mokweri/STM32F4-Board/README.md

# STM32F4-Board
Development board based on STM32F407

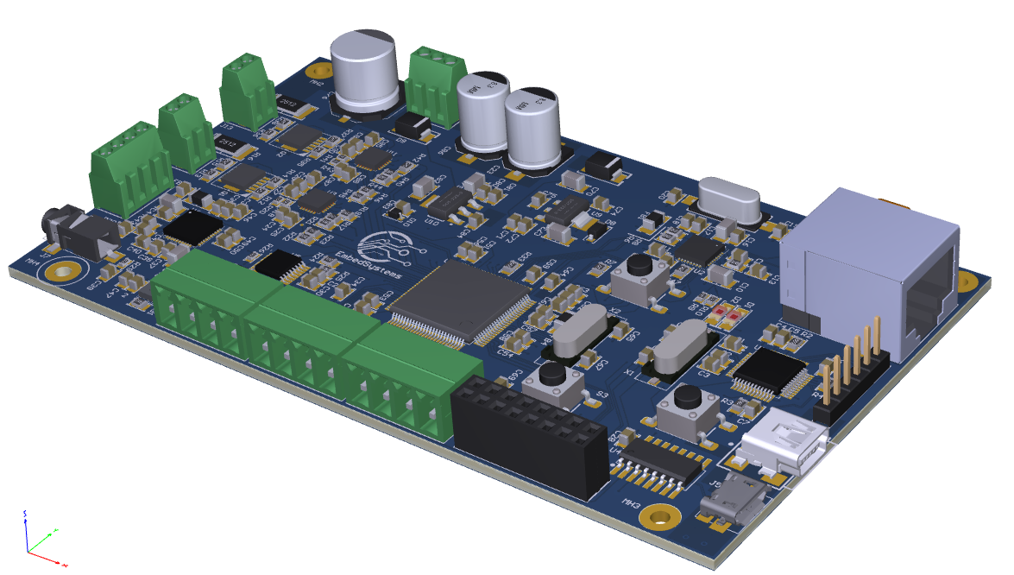
[picture p1: Release Files/images/6.PNG]
