mokweri/STM32F4-Board/Design Documents/Project+Discussion.xlsx

Sheet: DAY-1
Main Controller | x gpio | Manufacturers | Jtag/swd
 | y i2c | Availability
 | z uart, | Costing
 | clock freq | Prog
 | Flash Memory | Resou
 | RAM
 | Voltage
Debugger | Controller should be from same family
 | no of bit should be same
no of address Locations | 2^no of bit
 | Clock Freq
 | Programing Interface
Ethernet PHY | Datalink Layer
 | Physical Layer
MII/RMII | Media( Twisted, Fibre optics etc)
mii (16 Signal) | 100Mb/s
rmii (7 signal) | 1000Mb/s
gmii | 10,000Mb/s
MII Clock | 25Mhz
Phy | Driver Avail.
UART TO USB Conveter | FTDI232, CH340C
Parameter for ADC | No of Bit | 24
 | Reference Reg | 5V
 | Prog Gain Amp | 128
 | Sampling Rate | 100SPS
 | Data+ Data- | 0 to 10mv
4 Wire load cell | CM (Voltage b/w Data pin and GND) | 5V
Sesnor (5KG Load Cell)
Seensitivity | 1mgrm/v | 5mgrm
Extitation Voltage | 5v
No of steps | 1000000
Min no of Bits required | 20
SAMPLING Rate | 1000 sps
Sampling Filer
no of channel | 1 diff channel
Conectivity | UART, I2C, SPI
Feature ADC | ESD, Noise rejection
Noise free bits
Effective Biits
Voltage Level
Motor Driver | Bi Directional
 | 0 -100% | PWM
 | Voltage Level Motors | 12v
 | Logic level Voltage | 3.3v
 | Motor Type | Brushed DC
 | Technology | Power Mosfet
 | Interface | 1 gpio, 1pwm
 | Protection | Overcurrent,
 | Sense Current | 1 ADC
 | Price
Mosfets | RDS(ON) | Should Min
 | I Drain | >3.5A
 | V (GS) | >9V
 | IDS(Off) | Min
 | Power Dis | iload^2 x RDS(ON)
 | RT(JA) | Min
 | Total Gate Charge | delay(charge the gate) | min
 | Switching Loas (inc) with total gate change
 | No of elements | 4
Dac | Sampling Rate | 64x Fs
 | No of channel required | 1
 | Interface | I2S
 | Resolution | 32bit
 | no analog O/P | 1 For headphone, 1 speaker
 | Volatge Level | 3.3v
 | integrated Microphone | 1
 | monotocity
 | Range of Audio(db) | High minus -low Audio
Main Controller | STM32F407VGT6
Programmer/debugger | STM32F103CBT6
Ethernet PHY | DP838261RHBR
UART TO USB2.0 | CH340C
ADC (Load cell) | ADS122C04IPW
motor driver | DRV8701E
mosfet | DMHT6016LFJ
DAC with Mic

Sheet: DAY-2
STM32F103 | Page-11 | Block Diag
 | Page- 15 | Booting Config
 | Page-26 | PIN Names, Package info
 | 28-33 | Pin Config Table
 | Page-35 | Load Cap, VDD
 | Page-36 | Voltage Page
 | Page-37 | Max Power Est
 | Page-51 | Clock Config
 | Page-60 | ESD Table
 | Page-68 | Reset
 | Page-70 | I2C Pull-ups
 | Page-78 | Design Guidelines
Bypass Caps
Series Termination Resistance | 1Mhz | 3.3v<x
 | ns
10R | 0.2V

Sheet: Day-3
ESD DIODES/TVS DIODES | Leckage Current
ESD3V3D9 | Standoff voltage | 3.3V
 | Break down voltage | >3.3V
 | Clamping Voltage
 | Paracitic cap | Min
XC | 1/2 PI F C | FC(High), C(High) Imp (Low)
 | TX+, TX-, RX+, RX-
Magnetics with RJ45 | RJ45 With Mag
G8X-188S7-BP
 | Working Voltage
 | Isolation Voltage
 | Speed
Ferrite Bead | R dc | Min
MPZ1608B471ATA00 | IMP | Maximum
 | FREQ | Range of freq
 | Current | Current of line
SWD/JTAG
SWD | SWDIO, SWCLK, GND
JTAG(4/5) | JTNRST, JTCK, JTMS, JTDI, JTDO, GND
SWD | JTAG
Programming / debugging | testing (Max processing)
Arm arch | independent
print during deb | not
Symbol Desing | IPC-STD-2612
Footprint | IPC-STD-7351

Sheet: DAY-4
ICHOP | 3A
VREF | ? | 3.05V
VOFF | 0.05V
AVDD | 4.8V
Gain | 20
Vout | r2*vin/(r1+r2)
3r1+3r2=r2*4.8
r1/r2 | 1.8/3.3 | 0.5
r1 | 1.5k
r2 | 3k
Page no | 17
application Page | 28
BULK CAPS
CMIN | D*(1-D)*IO/ DELV*Fsw
D | Vo*100/VIN*eff
I0 | 7.6A
VIN=VOUT | 12V
fsw | 60000
eff | 81
delv | 0.12
D | 1.2
Cmin | 250uF
3A | ~100uF
ESR | min
Ripple Current | Max
ADC
Page No | 52 | Filter Calc
FC | 1/(2*PI*(R1+R2)*CDIF) | r1=r2=1k
1000
CDIF | 100nF
CM1=CM2 | 10nF

Sheet: DAY-5
Charge Pump: | i/p 12v | 24v | Caps | Polar | Non polar
 | 12 |  |  |  | Ceramic
Arangement of Capacitor, Diode, CLK, Gates |  |  |  |  | Class a, Classb
V1 + V1 | 2X 5V | Load voltage |  |  | Class a (Stable, Low Leackage, Low ESR)
Adv | Less compo | Min complex |  |  | MLCC(multilayer ceramic capacitor)
STM32F407
Page-19 | block | SWD/JTAG
Page-24 | Boot pins
Page-25 | PRD ON and Vdd conditions
Page-77 | VDDs, VREF, AVDD, GNDs |  | Pending
Page-82 | Low esr req. for Vcap1 &2 |  | PHY RESET | GPIO
Page-102 | Crystal req |  | Motor driver | 1 PWM, 3 GPIO, 1ADC _IN | X2
Page-112 | ESD Ratings |  | CH340C | 1GPIO
Page-119 | Reset conditions |  | ADC | 2 GPIO
 |  |  | DAC | 1GPIO
 |  |  | MIC | 1 PWM 1 GPIO
Place zener on 1.8
Change net labes motor-2

Sheet: DAY-6
Rules | Some Advantages of MultiLayer Board
First thing is these rules are not enough, because there can be 100s of Rules for a complex PCB. | increases the board's ability to distribute energy
1. ground plane boards are better because they allow signal routing in a microstrip or stripline configuration. It also significantly reduces the ground impedance and, therefore, the ground noise; | reduces cross-interference, eliminates electromagnetic interference
2-high speed signals should be "routed" on intermediate layers located between the various levels. In this way, ground planes can act as a shield and contain the radiation coming from the tracks at high speed | supports high-speed signals
3- a signal layer must always be adjacent to a plane | While a stackup level allows you to get multiple electronic circuits on a single board through the various layers of PCB board
4- Multiple ground planes are very advantageous, since they lower the board's ground impedance and reduce radiation in a common way; | a stack of PCB layers can help minimize the circuit vulnerability to external noise, as well as minimize radiation and decrease impedance and crosstalk problems on high-speed systems
5. the power to Power or GND to GND planes must be rigorously coupled together; | good PCB stacking can also contribute to efficient and low-cost final production;
6- Configurations should be symmetric. For example, on an eight-layer PCB, if level 2 is a plane, level 7 should also be a plane | a correct stack of PCB layers can improve the electromagnetic compatibility of the project.
7. Put the signal levels next to the levels of the plane (ground or power) the return current can flow on an adjacent plane reducing the inductance of the return path to a minimum; | The higher the number of layers, the more the designer is free to unravel his circuit, with less chance of stumbling into "impossible" solution
8. to further improve noise and EMI performance, insulation between a signal layer and its adjacent plane can be made even thinner;
9. an important consideration to be done is the thickness of each signal layer. There are standard thicknesses together with the properties of different types of printed circuit material. When selecting the materials, it is advisable to consider their electrical, mechanical and thermal properties;
Following Factors we have to thing Before and during the design
No of Layer
Number of Planes and Type of Planes
Sequence of Layers
Spacing b/w the Layers

Sheet: Grounding
Grounding
1- Leave nothing unconnected (Fill gnd)
2- Never split the gnd under the signal (Multilayer )
Always connect gnd on common point
Minimize the series via (High freq)
Try to route GND tracks from the biginning (2 layer , 1 layer)
GND to Chasis GND
Reason of Chasis should be gnd(To electric shock)
Current flow from body
higher potential (Body is lower pot)
Lets suppose something touching chasis
0V at chasis
to maintain 0v on chasis we connect it to GND
Very Big PCB, (Try to place Low value cap and Mega ohm reg on every monting hole)

Sheet: day-10
Reverify the schematic | Power Nets | Loads
Critical (Reset, Analogs, sesnors, etc) -Create design rules for Clearance | 12v | 12v (Q2), 12V(U9) | R19
Differential Tracks | 12v Series element NETC84_2 | 3V3 (u8),
Digital tracks | 3V3 | 1v8(u6), 3v3(u6,u7),
Check for each polygon pour | 12v Series element NETC90_2 | 3v3(u5)
 | 1v8 | 3v3(u4)
Place all the designators and naming | 3v3 Series load Net c11_2 | 12v(q1), 12v(u3) | R43
Add a clearance rule for 5mil, adjust all the violations |  | 3v3(u2)
 |  | 3v3(u1)
Current density, Voltage drop (PDN Analysis)
A/unit area

Sheet: Bonus Session
All I/O Voltage Nets | Loads at different Volatge
12V | 12V (Q1,Q2), Current Sesnse (R19, R43)
Series Ele. Netc84_2 | NETC84_2 (U10)
3V3 | 3V3(U1, U2)
