mokweri/STM32F4-Board/Design Documents/7 Layers of OSI Model.PNG

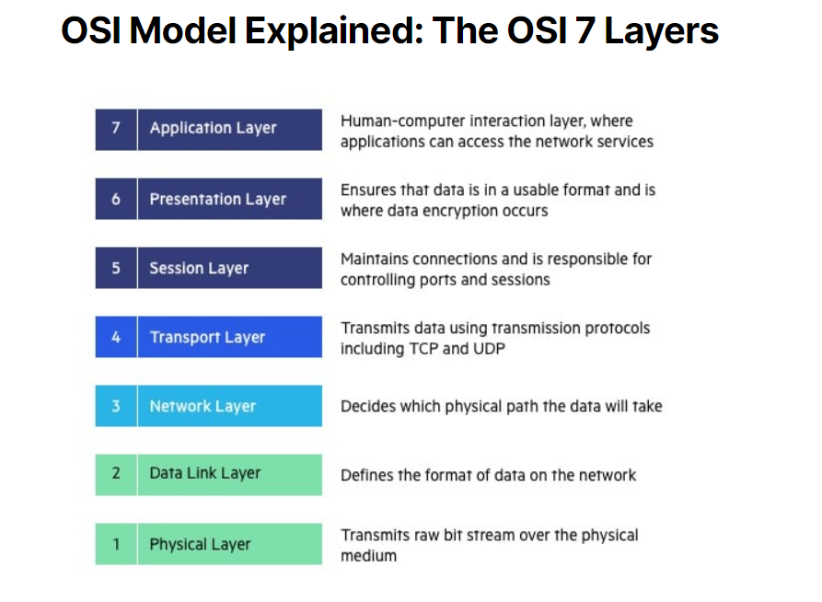
Design Documents/7 Layers of OSI Model.PNG
