mokweri/STM32F4-Board/Design Documents/Full bridge.jpg

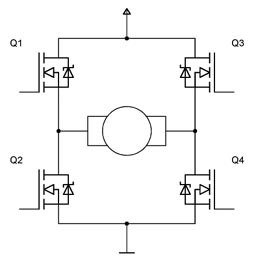
Design Documents/Full bridge.jpg
