mokweri/STM32F4-Board/Design Documents/Power Budget.PNG

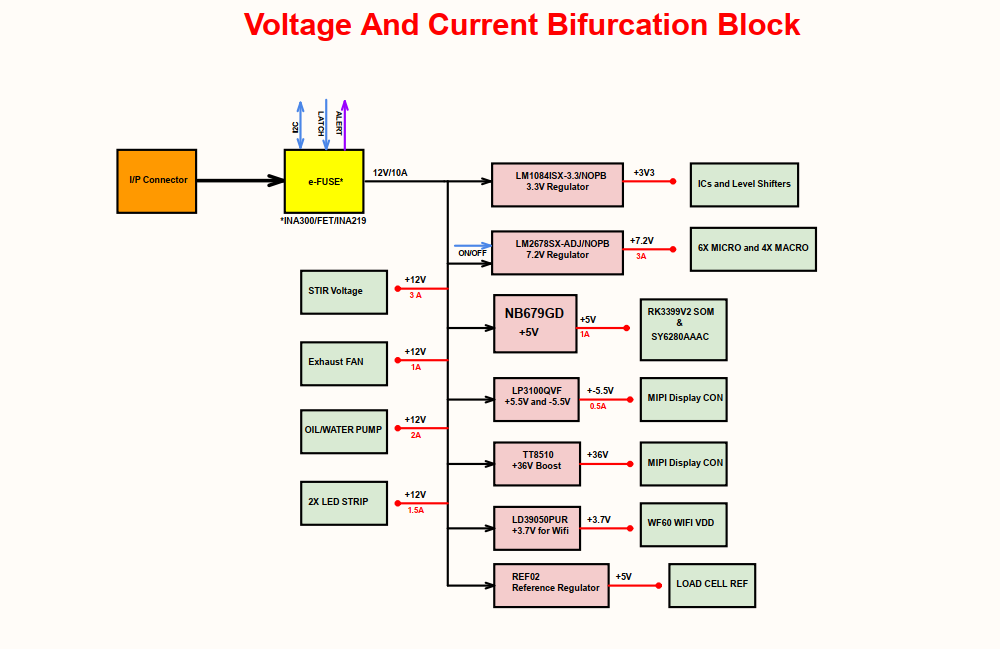
Design Documents/Power Budget.PNG
