mokweri/STM32F4-Board/Design Documents/Schematic Block.PNG

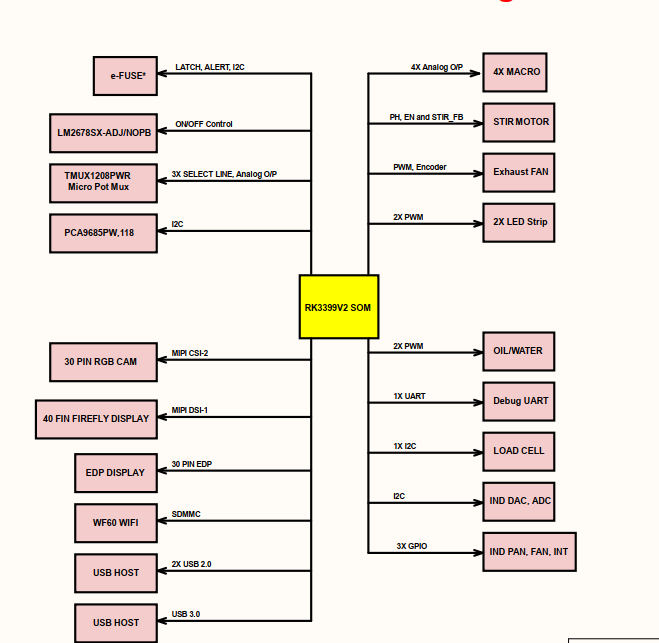
Design Documents/Schematic Block.PNG
