mokweri/STM32F4-Board/Release Files/images/1.PNG

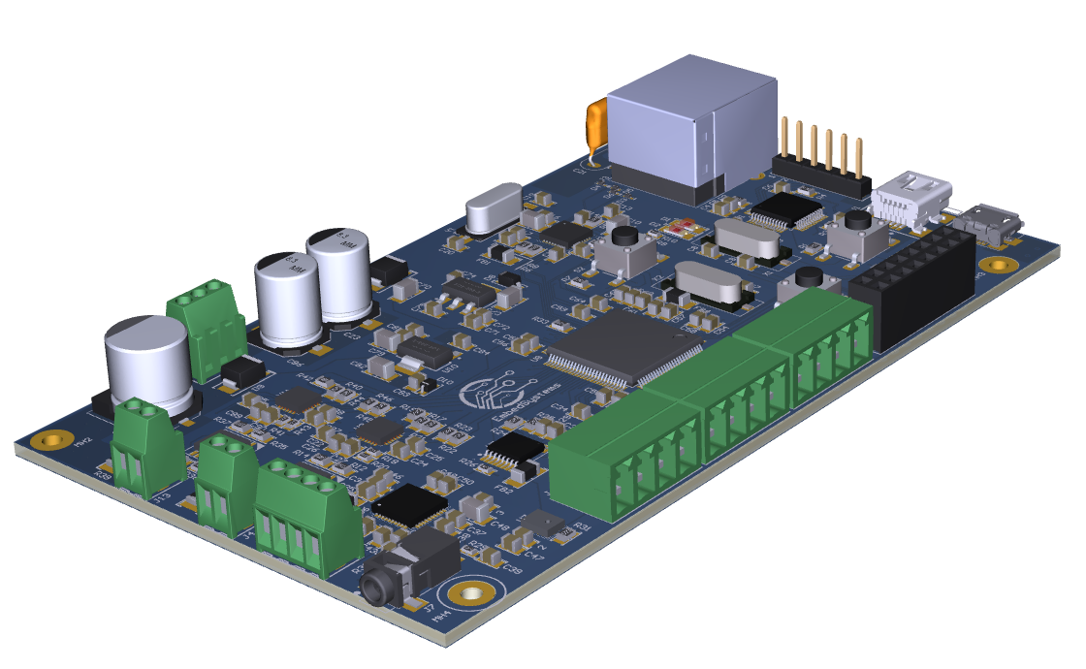
Release Files/images/1.PNG
