mokweri/STM32F4-Board/Release Files/images/2.PNG

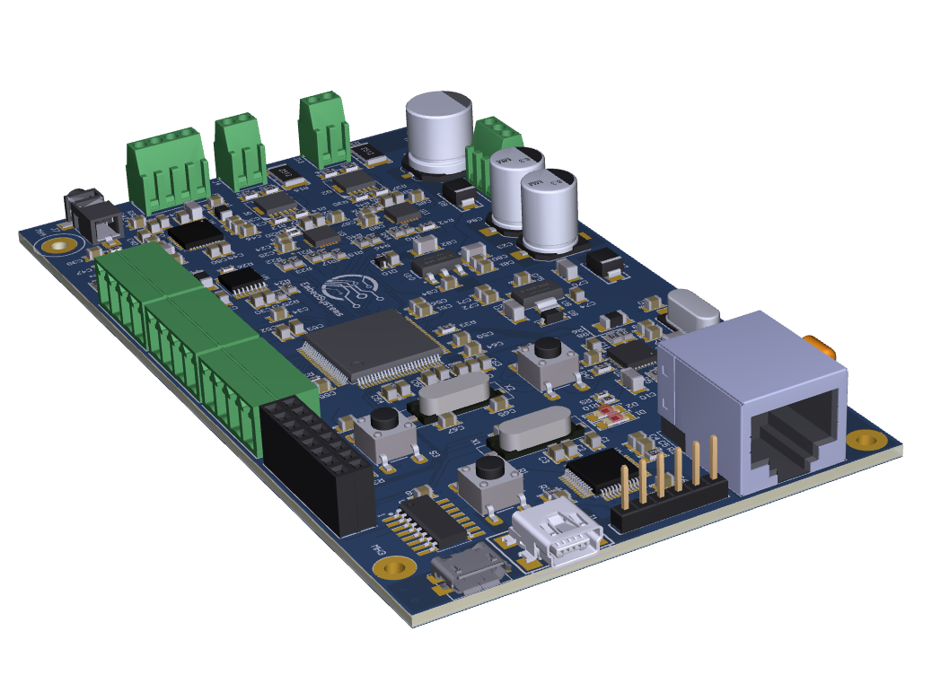
Release Files/images/2.PNG
