mokweri/STM32F4-Board/Release Files/images/3.PNG

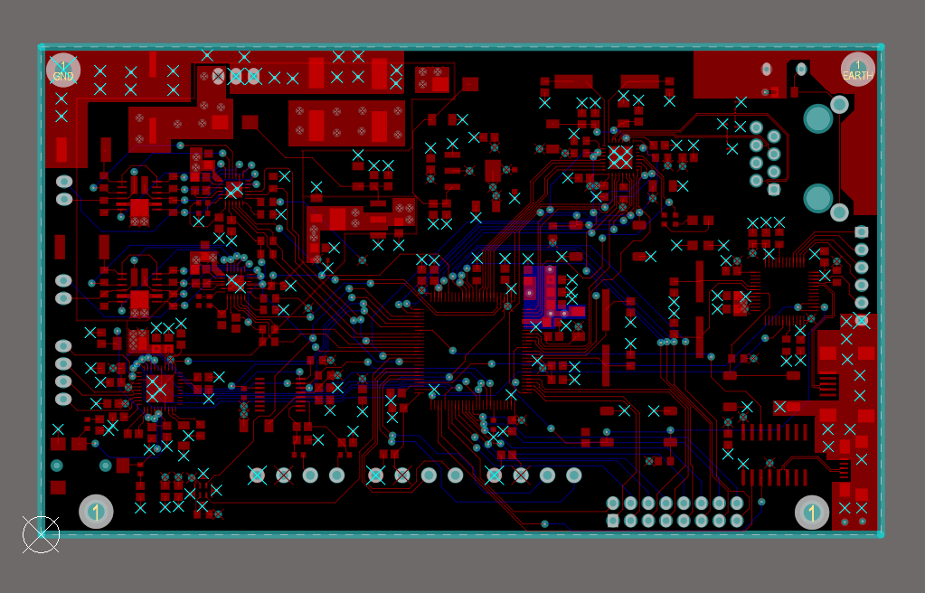
Release Files/images/3.PNG
