mokweri/STM32F4-Board/Release Files/images/4.PNG

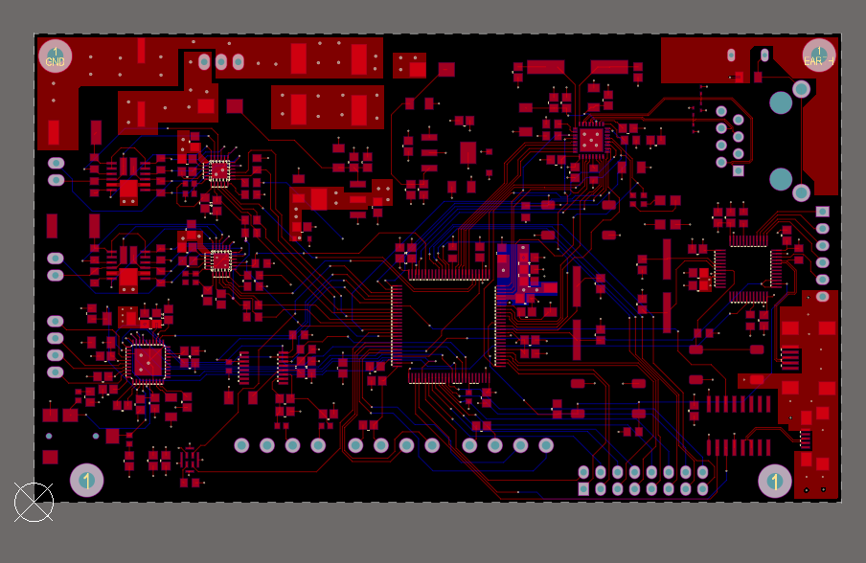
Release Files/images/4.PNG
