mokweri/STM32F4-Board/Release Files/images/5.PNG

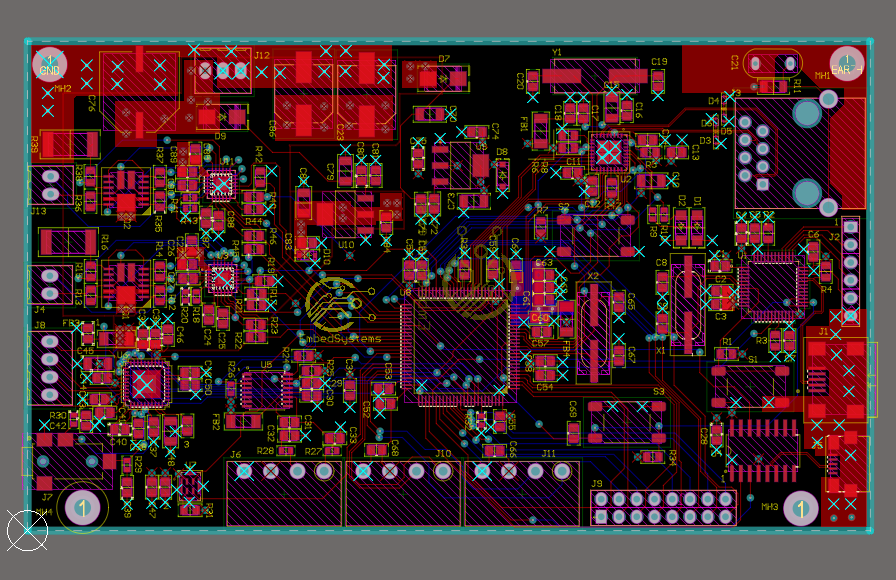
Release Files/images/5.PNG
