mokweri/STM32F4-Board/Release Files/images/Capture.PNG

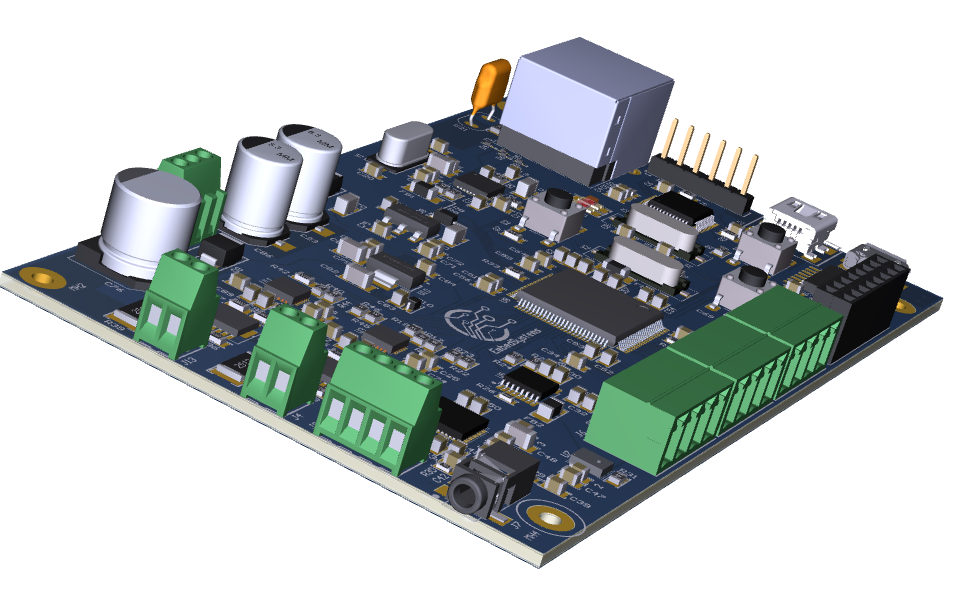
Release Files/images/Capture.PNG
