mokweri/STM32F4-Board/UC-4dbfa4fe-8ef9-4bf0-8c6b-0c34d0a2d7f8.jpg

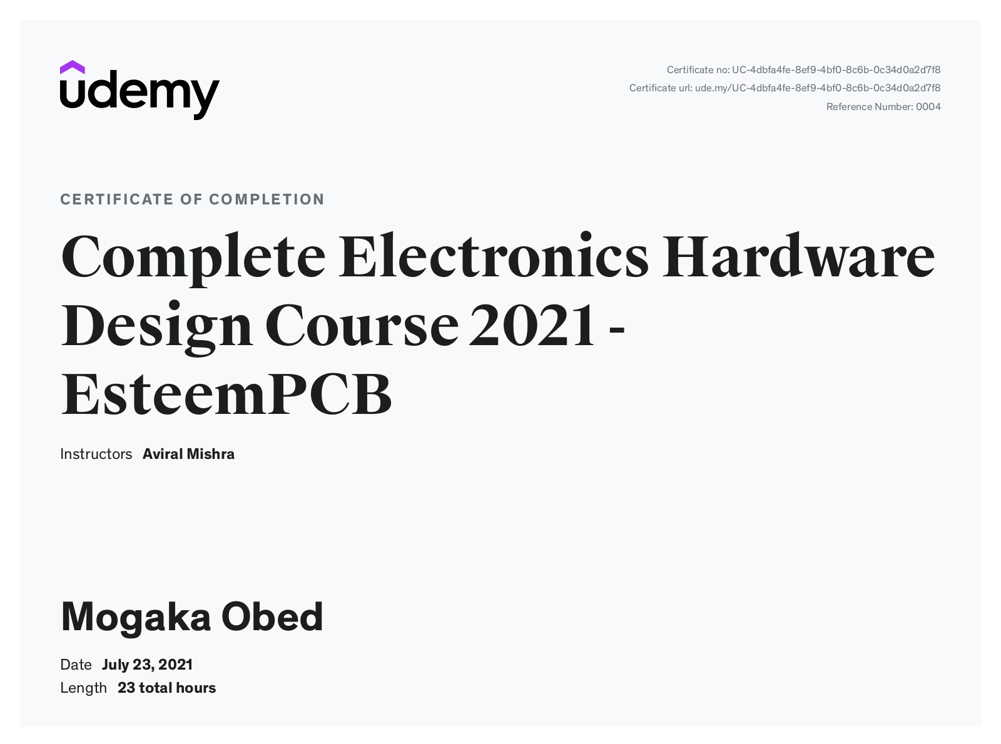
UC-4dbfa4fe-8ef9-4bf0-8c6b-0c34d0a2d7f8.jpg
