mokweri/STM32F4-Board/Design Documents/Reference schematic.PDF

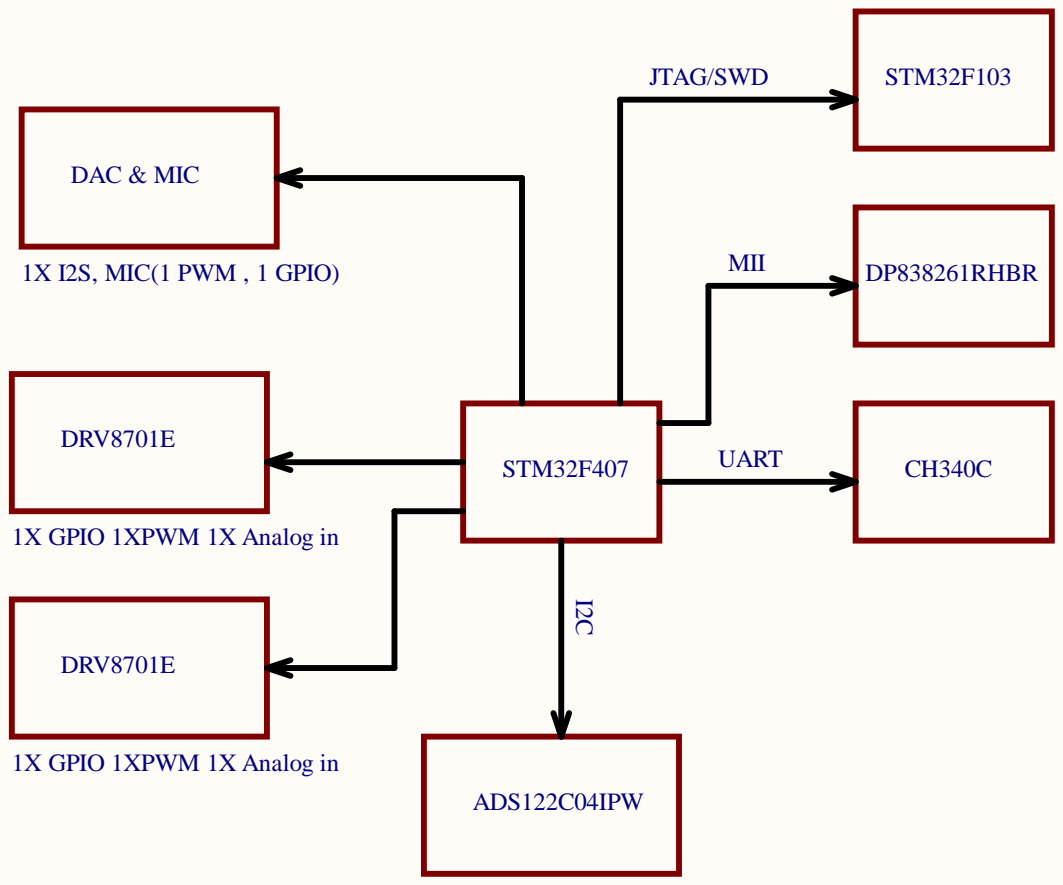
[picture p14: page 1]

Cannot open file
D:\Youtube\Logos and end
screen\logo_ESTEEM2.png

PROJECT CODE: A_V1.0 | 1 11 Sheet of
SCALE 1:1 | A4 TEMPLATE: | AVIRAL MISHRA AUTHOR:

This document is copyright of EsteemPCB and shall not be revealed, produced, copied, in whole or in part, nor used for any purpose other than submitted.

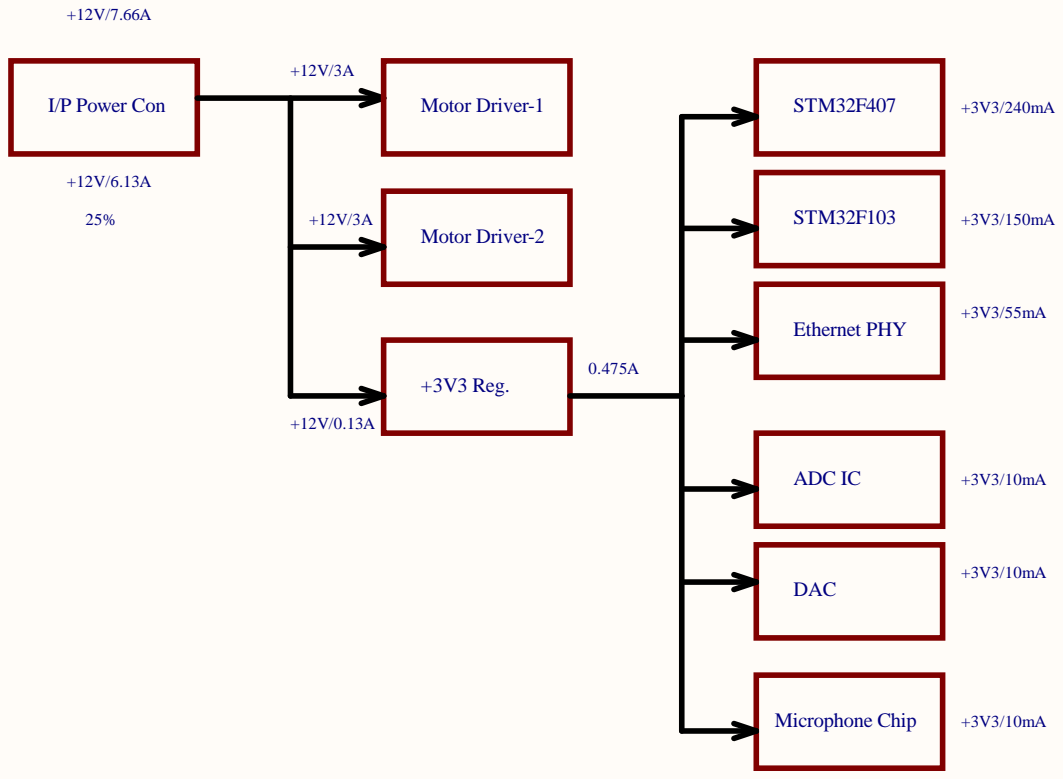
[picture p15: page 2]

Cannot open file
D:\Youtube\Logos and end
screen\logo_ESTEEM2.png

PROJECT CODE: A_V1.0 | 2 11 Sheet of

SCALE 1:1 | TEMPLATE:

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

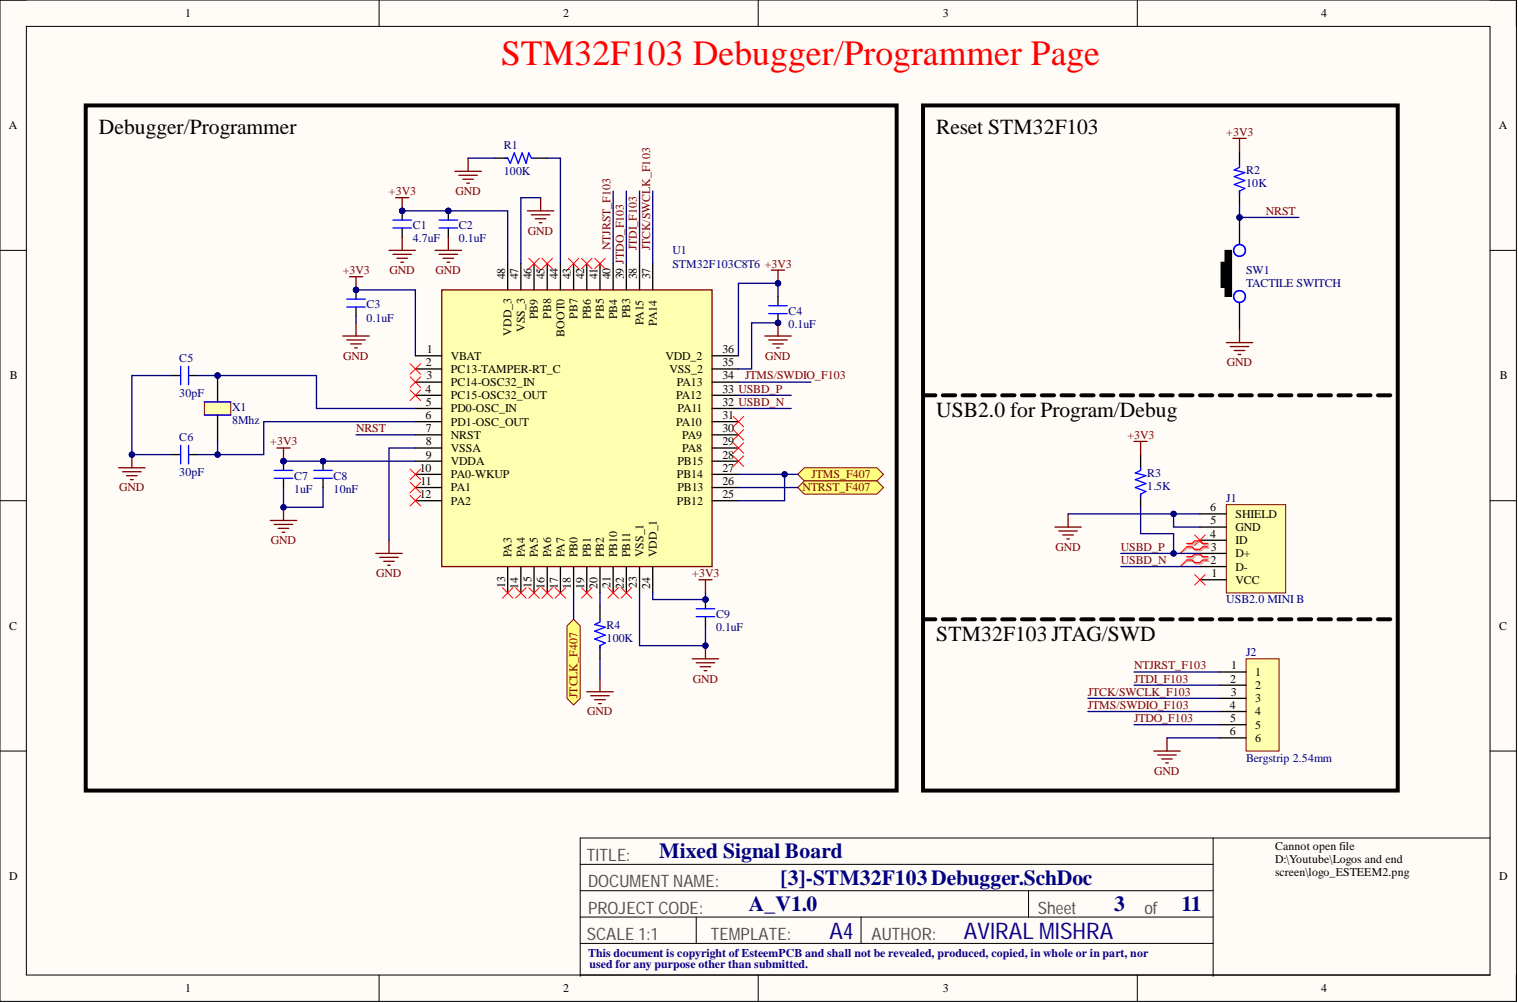
[picture p16: page 3]

NRST +3 V 3 | 7 | 3 0

8 | 2 9
9 | 2 8
1 0 | 2 7

A_ V 1 . 0 PROJECT CODE: | 3 1 1 Sheet of

SCALE 1:1 | TEMPLATE:

r used for any purpose other than submitted.

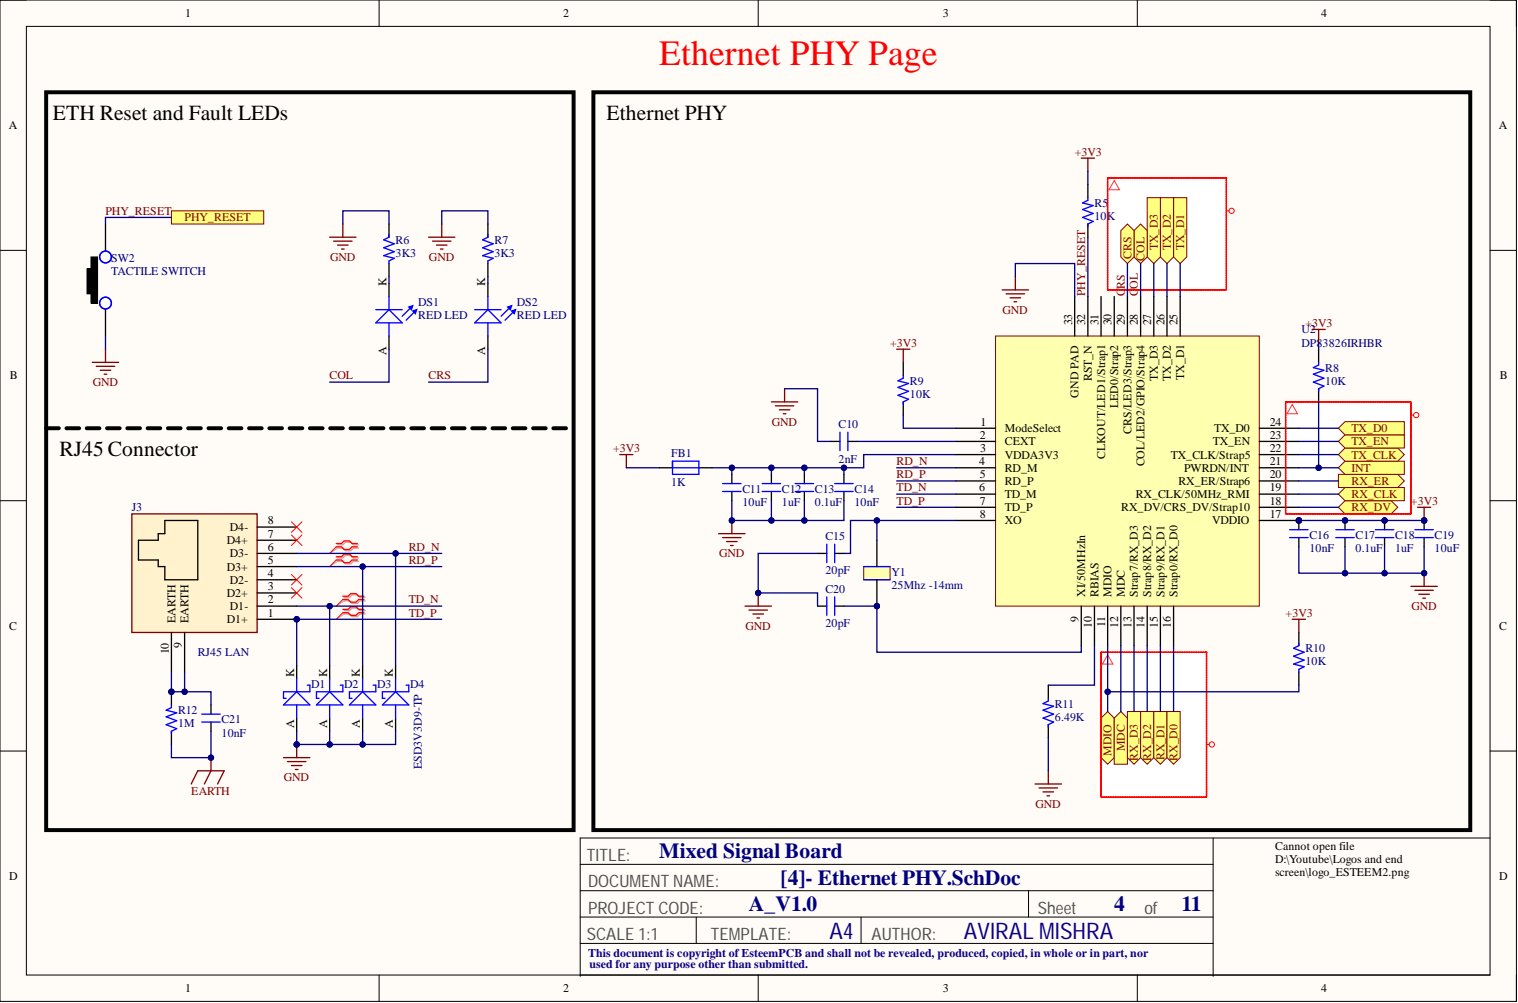
[picture p17: page 4]

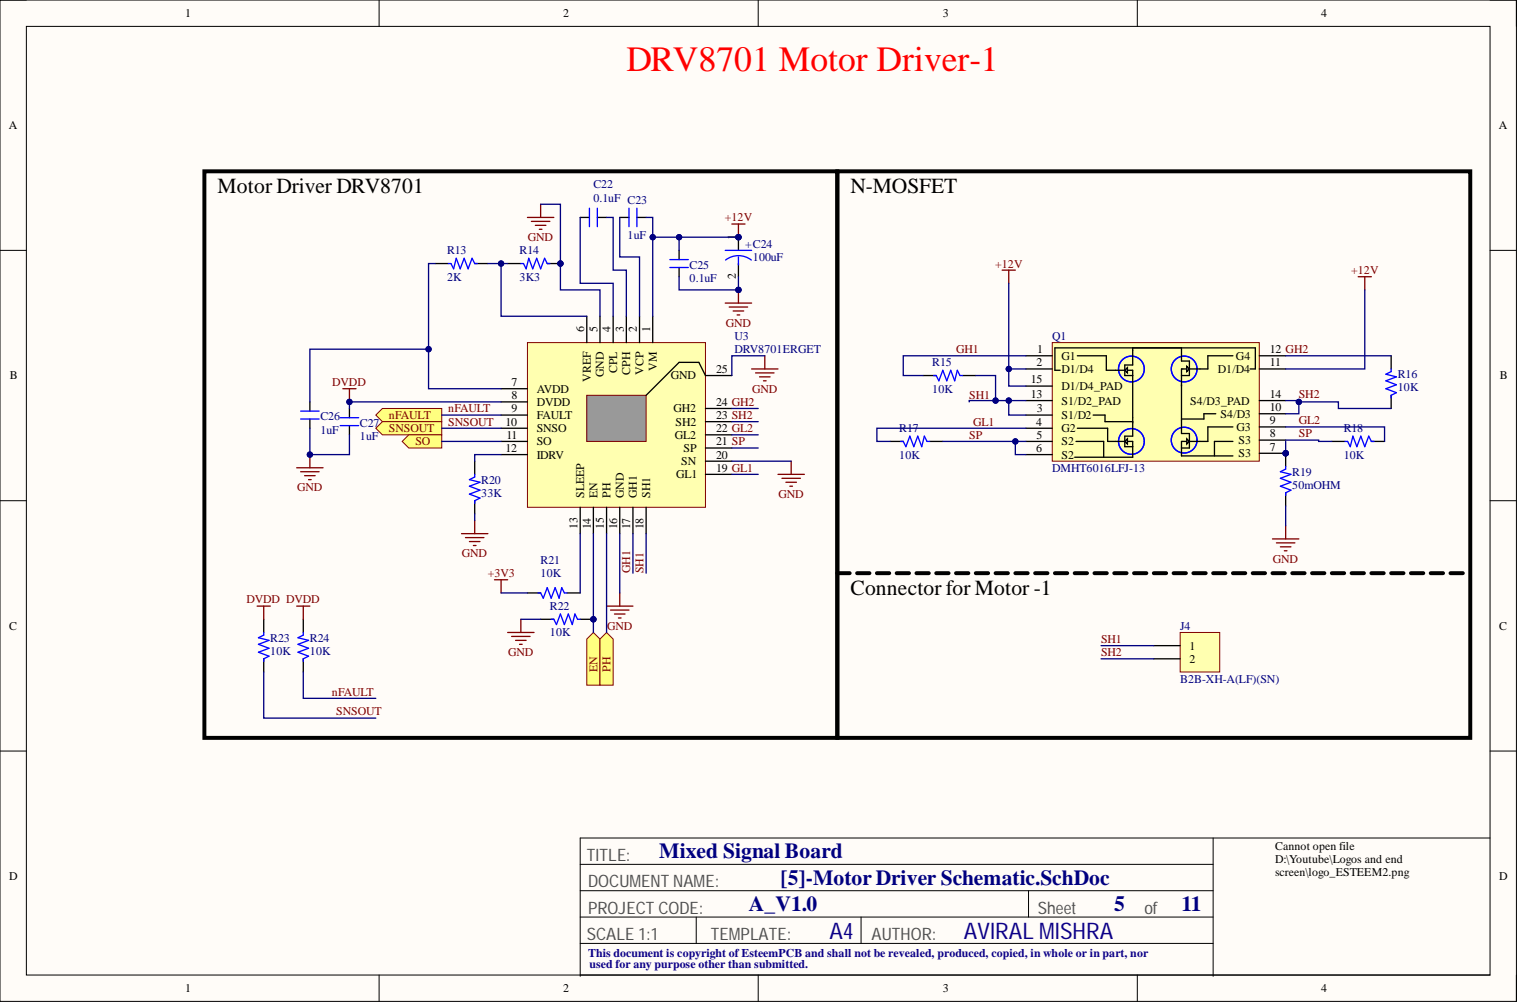
[picture p18: page 5]

7 0 1 C2 2 0.1 u F C2 3 | N-MOSFE T +1 2 V +1

VM 1 VCP 2 CPH 3 CPL 4 GND 5 VREF 6

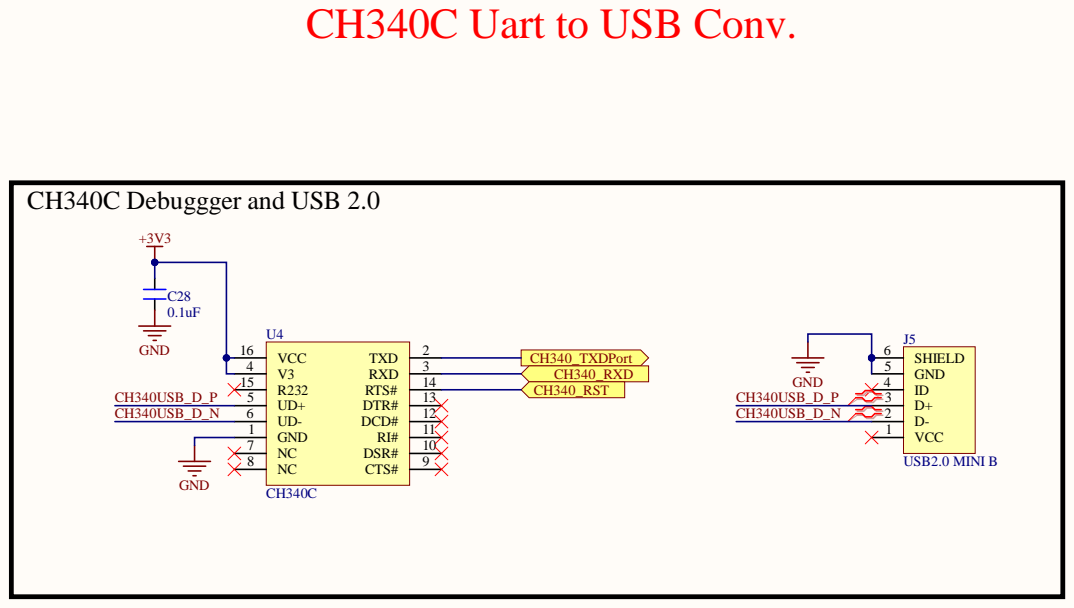
[picture p19: page 6]

CH340C Uart to USB Conv

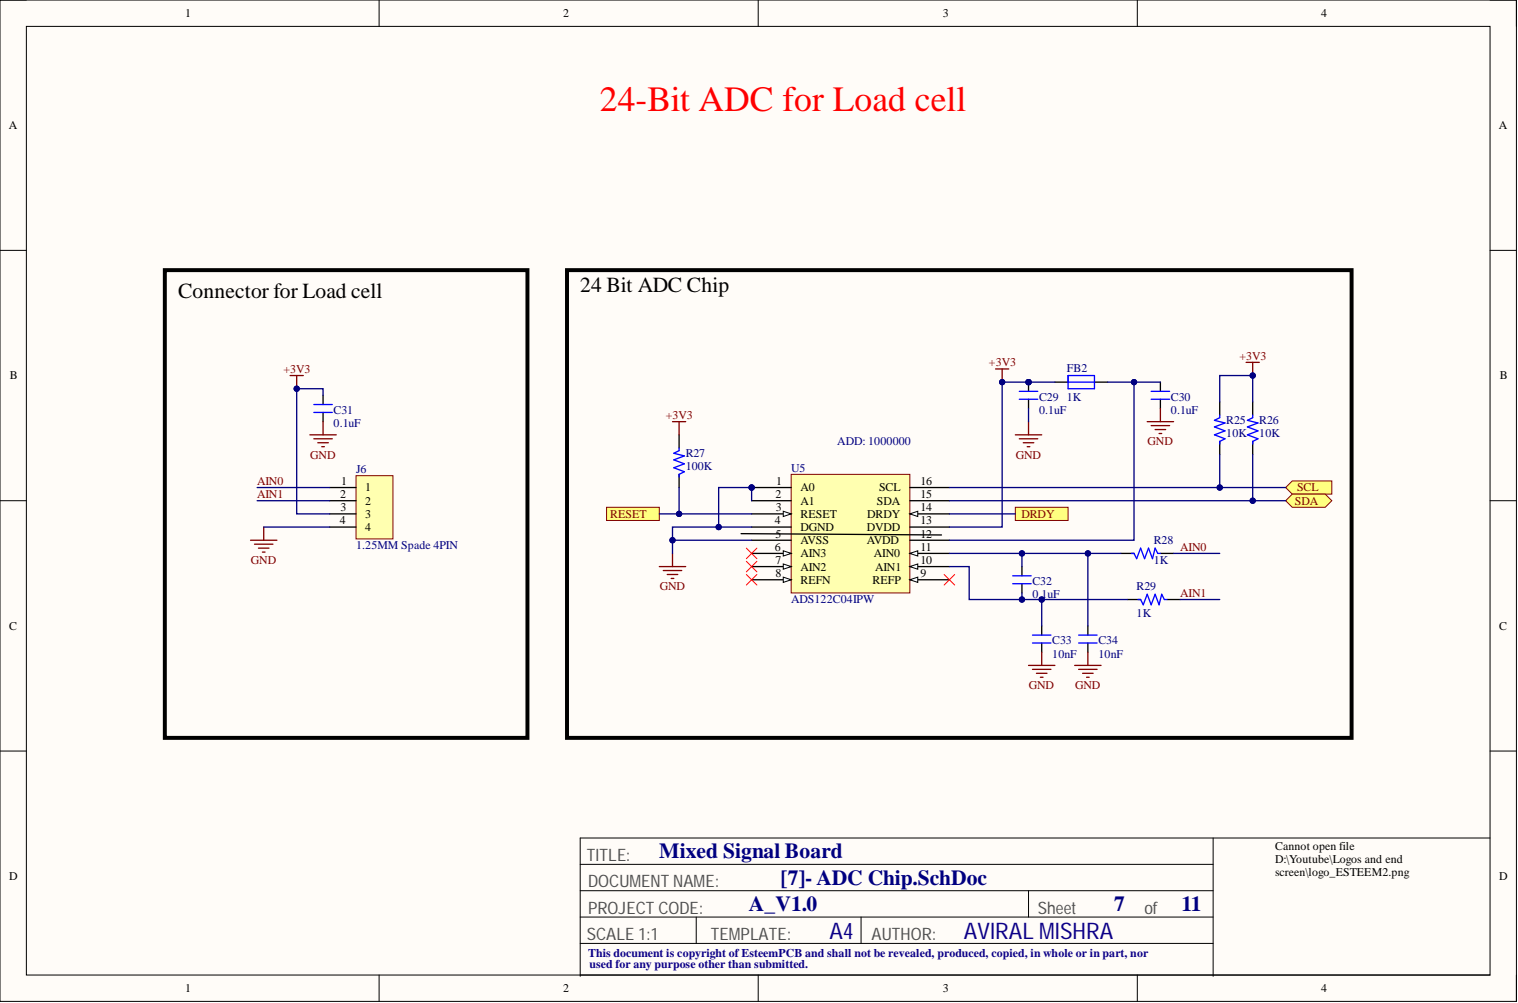
[picture p20: page 7]

24-Bit ADC for Load cell

2 | 15 SCL 16 4 SDA

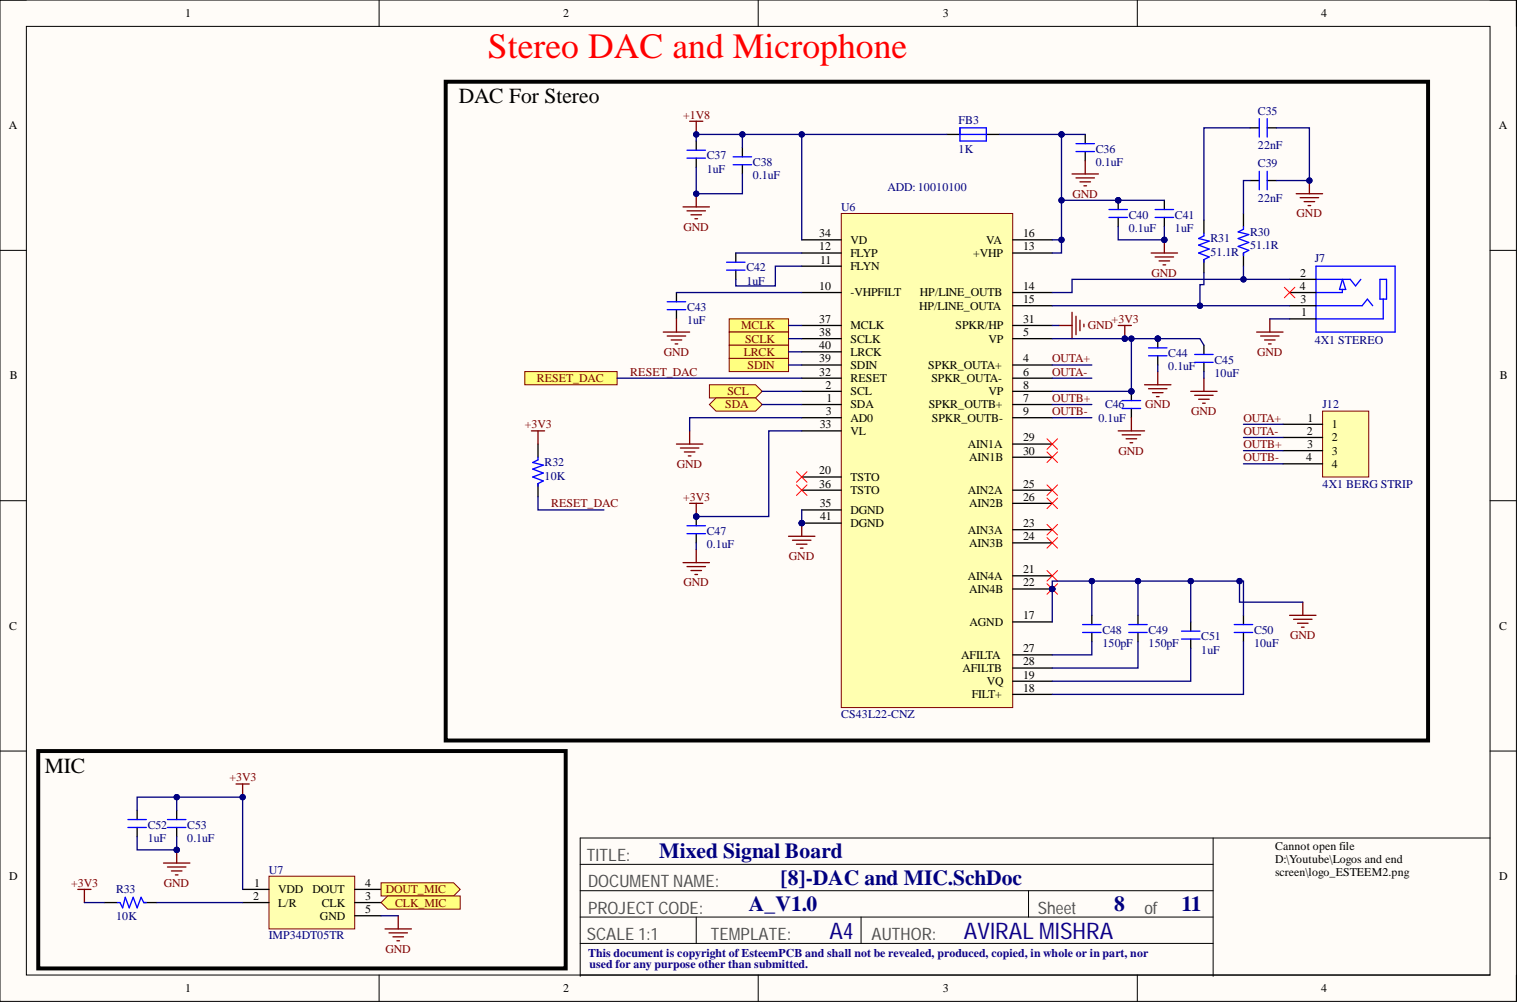
[picture p21: page 8]

Stereo DAC and Microphone

SDIN 39 LRCK 40 | OUTA+ | GND

RESET 32 | OUTA-

Cannot open file
D:\Youtube\Logos and end
screen\logo_ESTEEM2.png

[8]-DAC and MIC.SchDoc

PROJECT CODE: A_V1.0 | 8 11 Sheet of

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

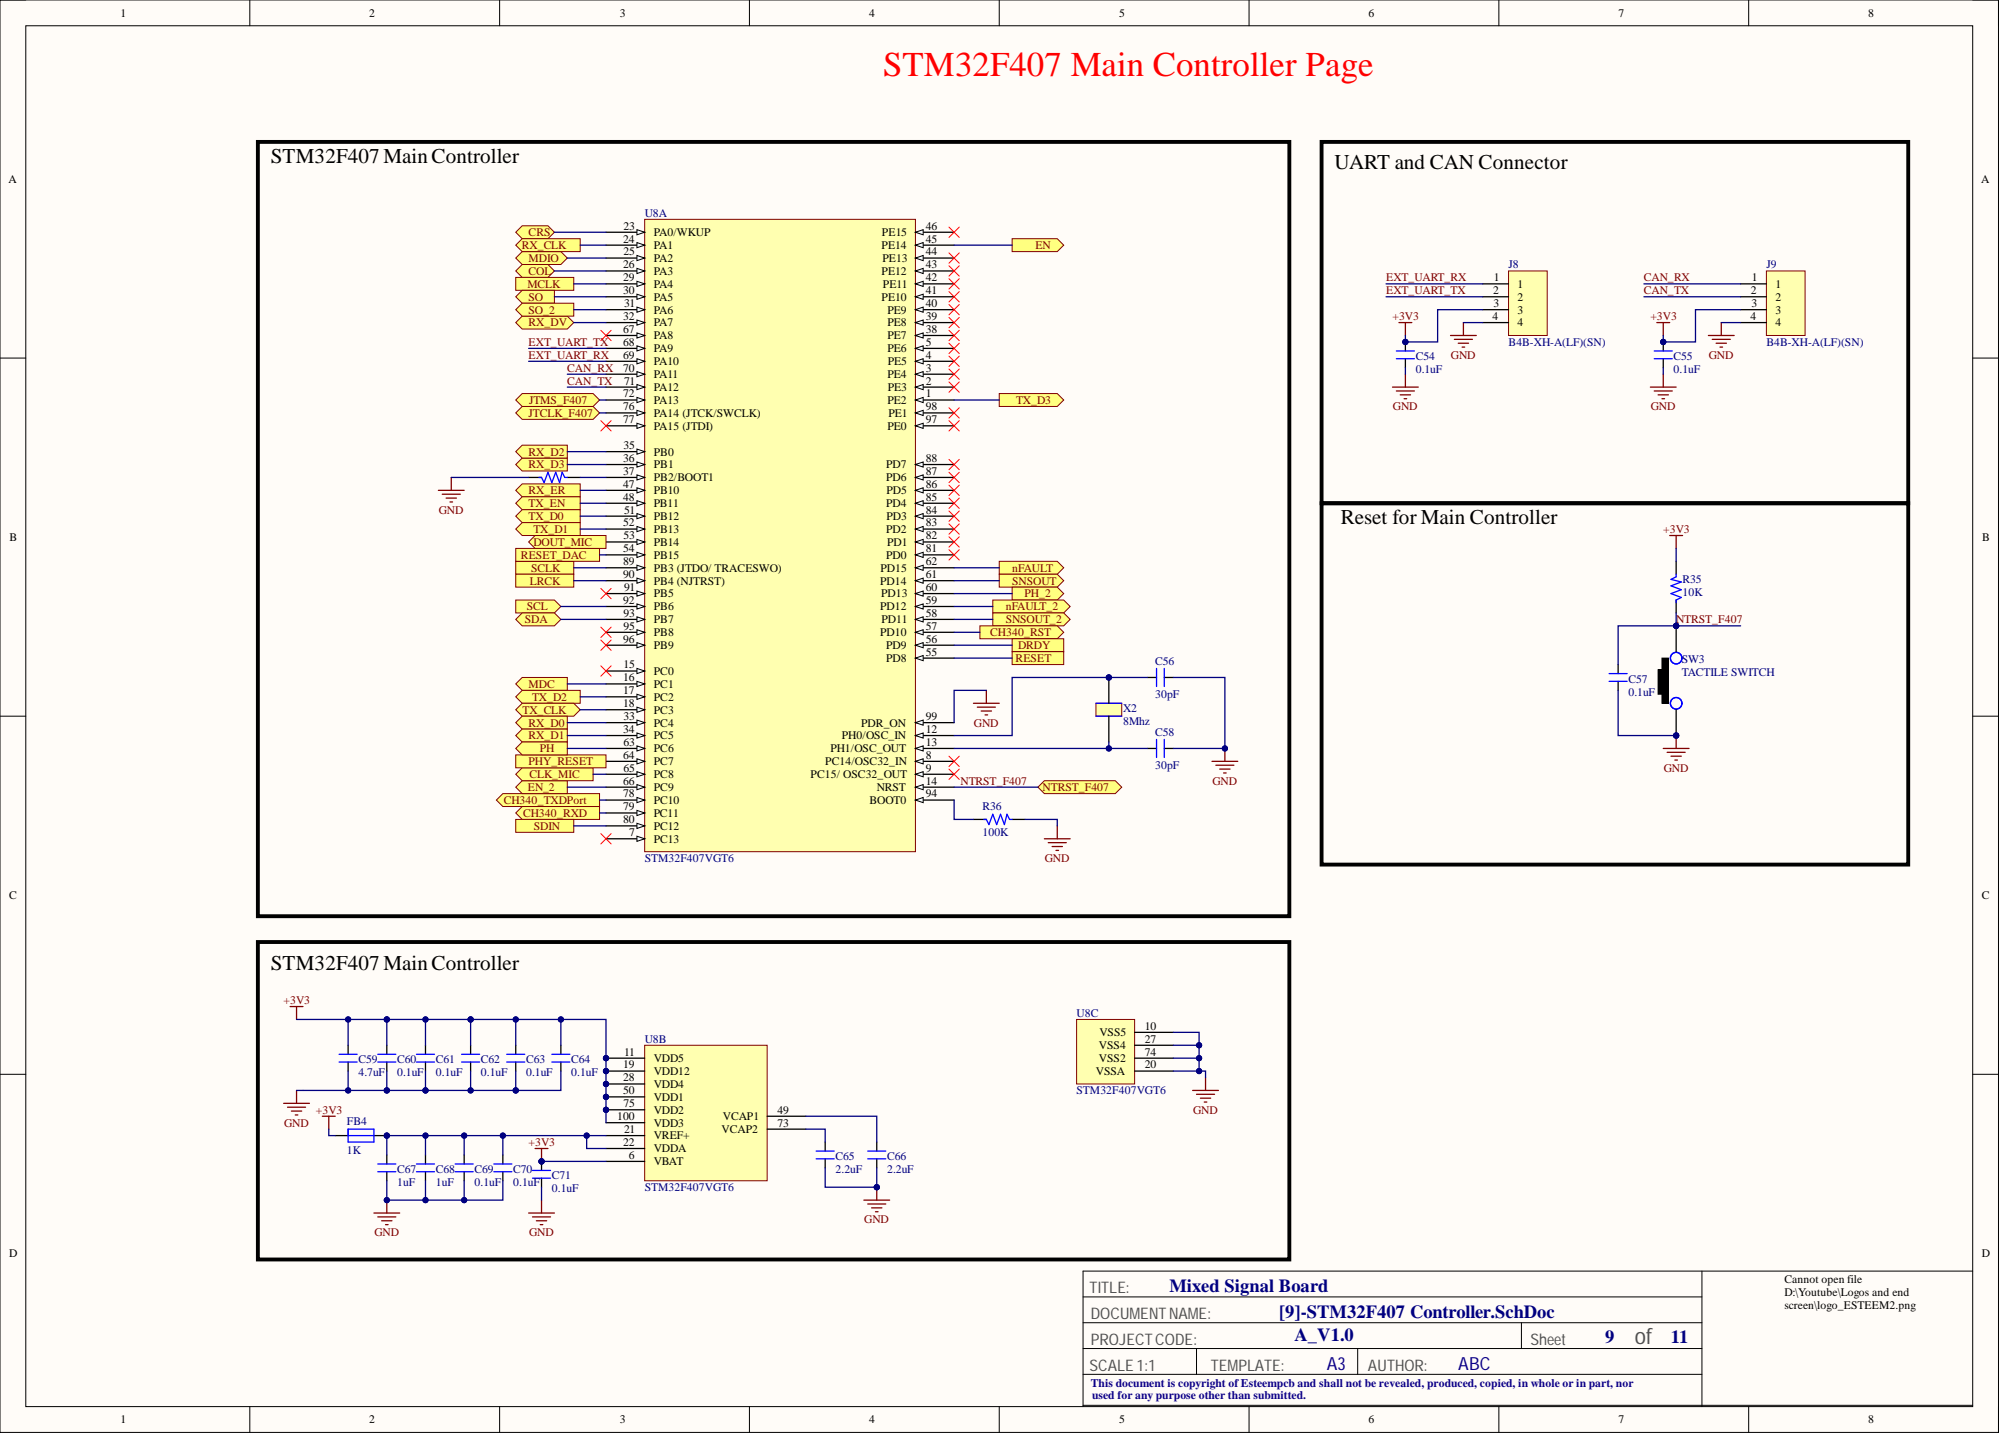
[picture p22: page 9]

A_V1 . 0 PROJECT CODE: | 9 of 1 1 Sheet

TEMPLAT E : A3 | AUTHO R : ABC

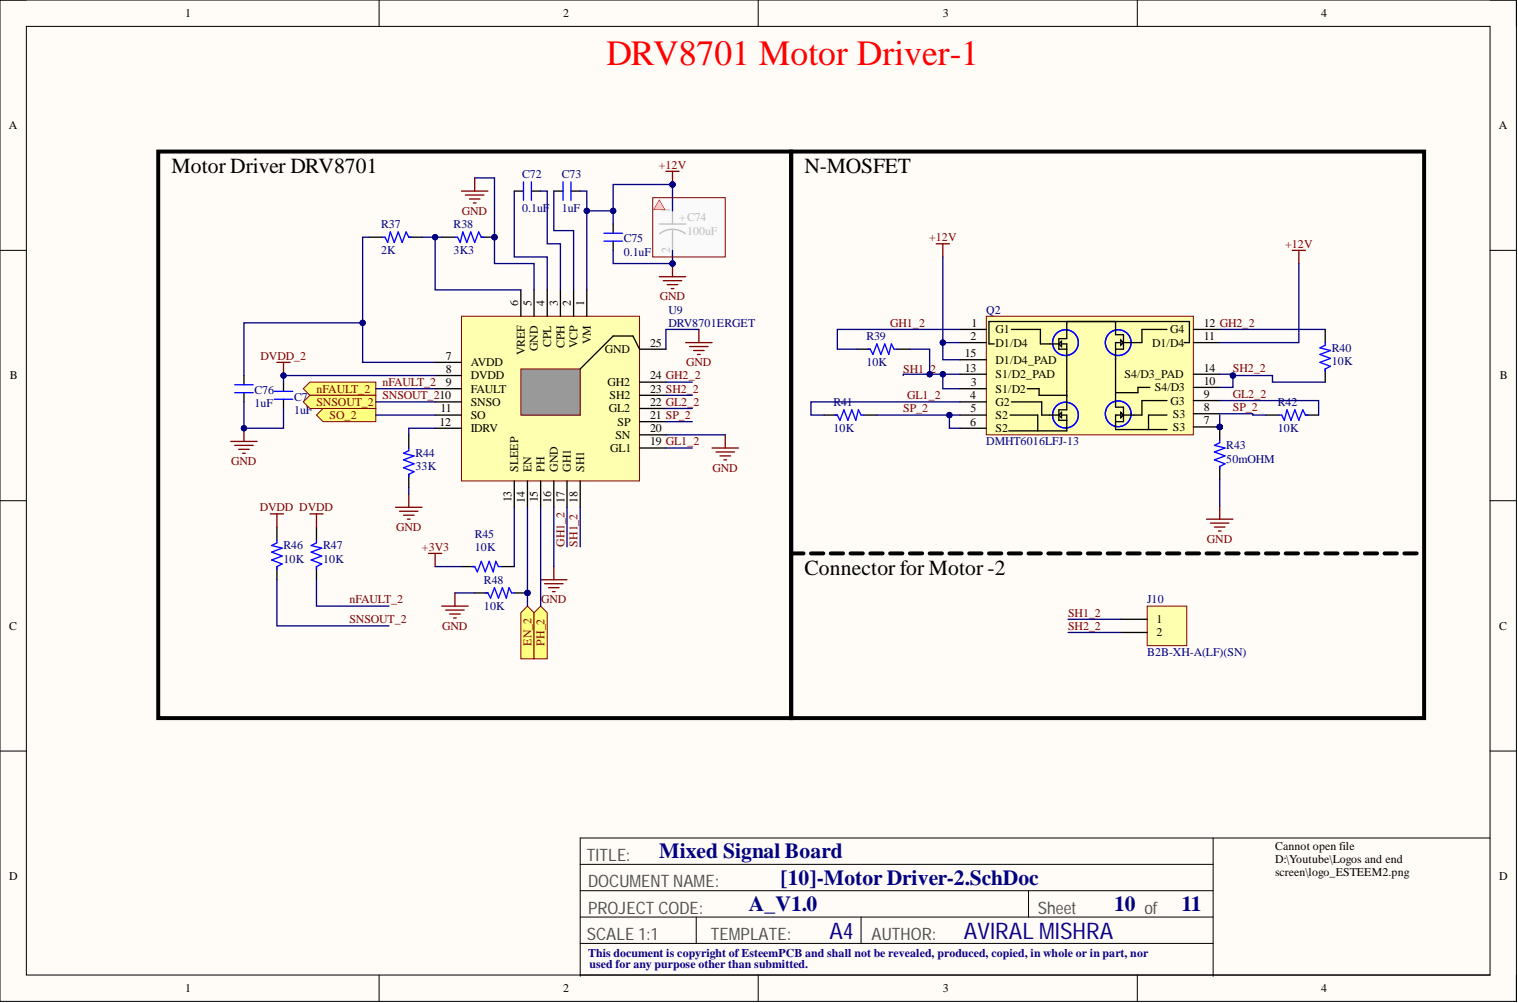
[picture p23: page 10]

Motor Driver DRV8 7 0 1 +1 2 V | N-MOSFE T +1 2 V +1

VM 1 VCP 2 CPH 3 CPL 4 GND 5 VREF 6

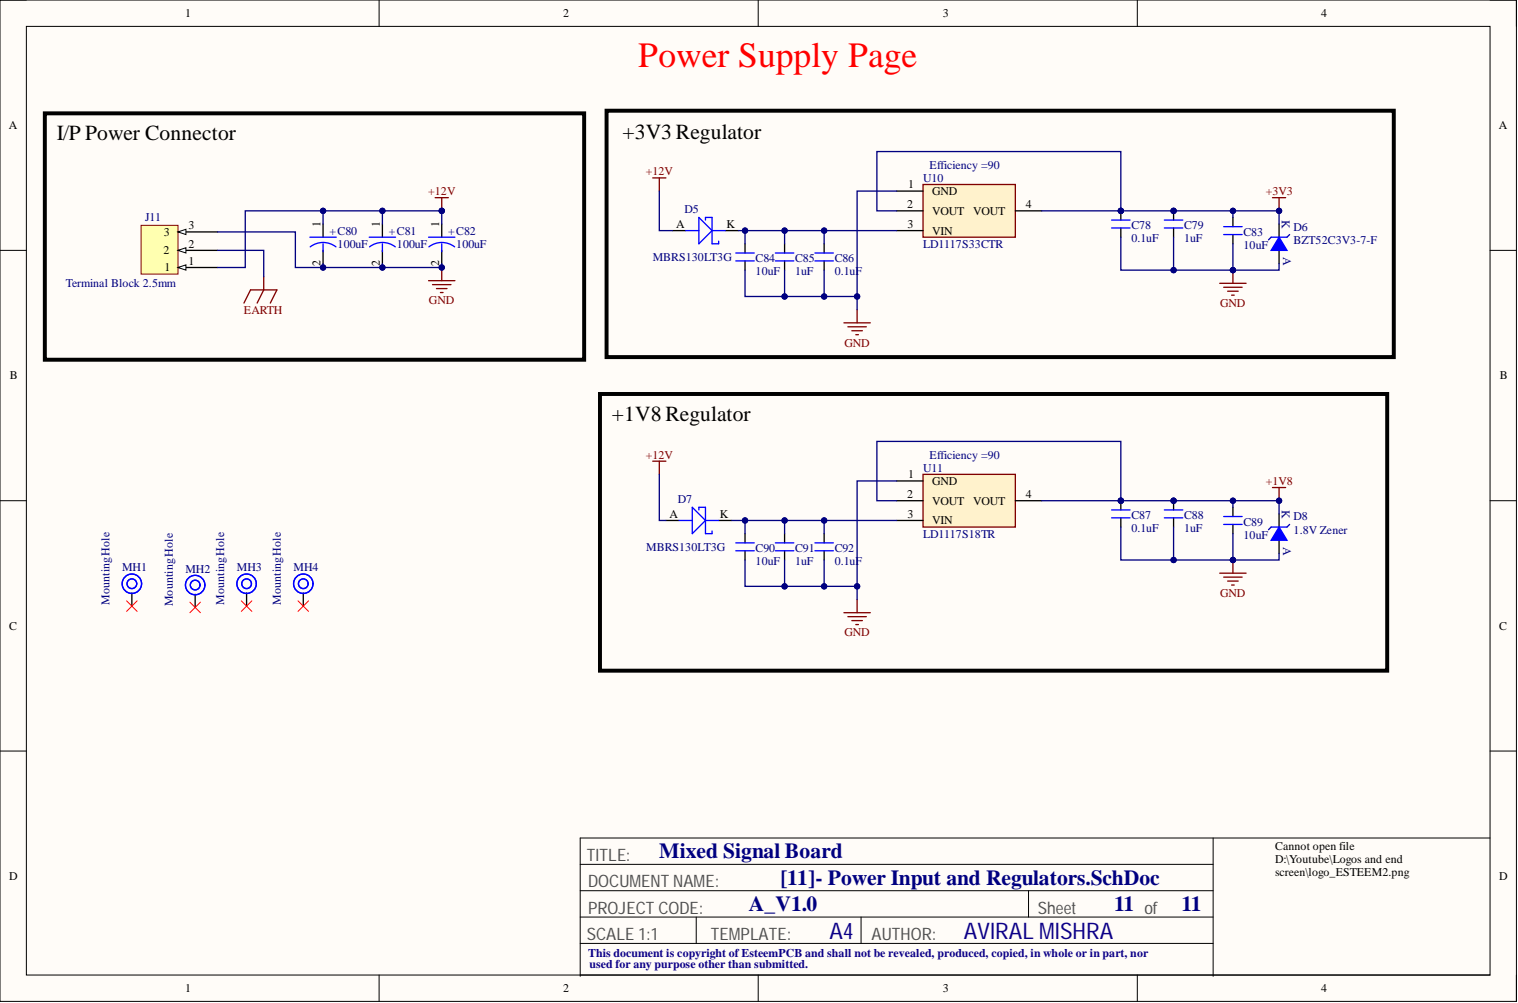
[picture p24: page 11]

+1V8 Reg ulato r
