mokweri/STM32F4-Board/(list of files, drawings)

Other design files:
Design Files/STM32F407_Board/[1]-Schematics Blocks.SchDoc
Design Files/STM32F407_Board/[2]-Power Budget.SchDoc
Design Files/STM32F407_Board/[3]-Debugger_STM32F103.SchDoc
Design Files/STM32F407_Board/[4]-Ethernet_PHY.SchDoc
Design Files/STM32F407_Board/[5]-Motor Driver_DRV8701.SchDoc
Design Files/STM32F407_Board/[6]-CH340C.SchDoc
Design Files/STM32F407_Board/[7]-ADC CHIP.SchDoc
Design Files/STM32F407_Board/[8]-DAC & MIC.SchDoc
Design Files/STM32F407_Board/[9]-STM32F407.SchDoc
Design Files/STM32F407_Board/[10]-POWER.SchDoc
Design Files/STM32F407_Board/[11]-Motor Driver_DRV8701_2.SchDoc
Design Files/STM32F407_Board/STM32F407_Board.PcbDoc
Design Files/STM32F407_Board/STM32F407_Board.PrjPcb
