mokweri/STM32F4-Board/(commit log)

2021-06-16 updated schematic
    [STM32F407_Board.PrjPcb, [3]-Debugger_STM32F103.SchDoc, [4]-Ethernet_PHY.SchDoc, [5]-Motor Driver_DRV8701.SchDoc, [6]-CH340C.SchDoc]
2021-06-16 added schematic pages
    [STM32F407_Board.PrjPcb, [10]-POWER.SchDoc, [3]-Debugger_STM32F103.SchDoc, [7]-ADC CHIP.SchDoc, [8]-DAC & MIC.SchDoc, [9]-STM32F407.SchDoc]
2021-06-17 updated schematics
    [[3]-Debugger_STM32F103.SchDoc, [4]-Ethernet_PHY.SchDoc, [5]-Motor Driver_DRV8701.SchDoc, [9]-STM32F407.SchDoc]
2021-06-17 finished schematic_unverified
    [STM32F407_Board.PrjPcb, [10]-POWER.SchDoc, [11]-Motor Driver_DRV8701_2.SchDoc, [1]-Schematics Blocks.SchDoc, [2]-Power Budget.SchDoc, [3]-Debugger_STM32F103.SchDoc, [4]-Ethernet_PHY.SchDoc, [5]-Motor Driver_DRV8701.SchDoc]
2021-06-21 resolved schematic warnings
    [STM32F407_Board.PcbDoc, STM32F407_Board.PrjPcb, [11]-Motor Driver_DRV8701_2.SchDoc, [3]-Debugger_STM32F103.SchDoc, [4]-Ethernet_PHY.SchDoc, [5]-Motor Driver_DRV8701.SchDoc, [6]-CH340C.SchDoc, [7]-ADC CHIP.SchDoc]
2021-06-27 updated placement
    [[3]-Debugger_STM32F103.SchDoc, [8]-DAC & MIC.SchDoc]
2021-07-07 started routing
    [[3]-Debugger_STM32F103.SchDoc, [4]-Ethernet_PHY.SchDoc, [6]-CH340C.SchDoc]
2021-07-22 layout finished 1
    [STM32F407_Board.PrjPcb, [10]-POWER.SchDoc, [4]-Ethernet_PHY.SchDoc]
